trinamic/TOSV-AddonHardwareReferenceDesign/README.md

# TOSV-AddonHardwareReferenceDesign
Reference Design for the TOSV Pressure Sensor Addon Board
