trinamic/TOSV-AddonHardwareReferenceDesign/TOSV-SENSOR-REF V1.0/Production files/Transcode Report.txt

   ---- Transcoding 'Y:\Syslab\Projekte\TMCM-0021 (TOSV Addon Board)\hardware\TMCM-0021 v1.0\Production files\TMCM-0021 v1.0-B_Cu.gbr' ----   Tue Jun 02 15:44:44 2020

D10   --> D100
D11   --> D101
-----------------------------------------------------------------
