trinamic/TOSV-AddonHardwareReferenceDesign/TOSV-SENSOR-REF V1.0/Documentation/TMCM-0021 v1.0 - 3D rendering top.png

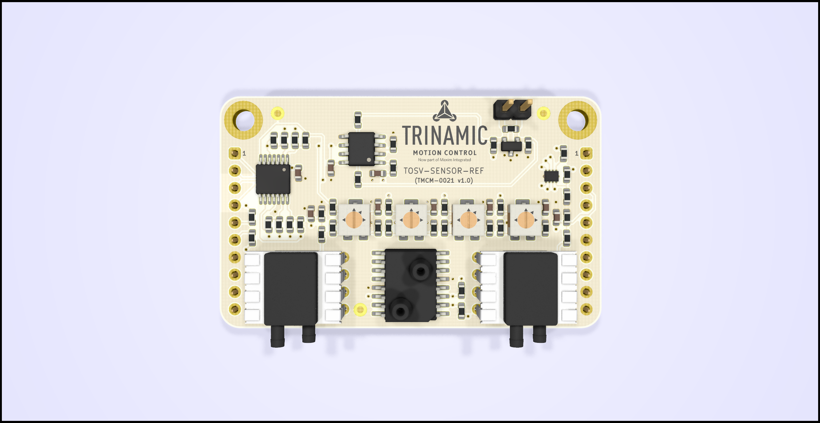
TOSV-SENSOR-REF V1.0/Documentation/TMCM-0021 v1.0 - 3D rendering top.png
