trinamic/TOSV-AddonHardwareReferenceDesign/TOSV-SENSOR-REF V1.0/Documentation/TMCM-0021 v1.0 - BOM.xlsx

Sheet: Revision hisroty
Release | Date | Comment
TMCM-0021 v1.0 | 2020-05-26 | First release

Sheet: BOM
Parts list
TMCM-0021 v1.0
2020-05-26
# | REFDES | QTY | VALUE | PACKAGE | INFO | ASSY | MANUFACTURER | MANUFACTURER PN | SUPPLIER | SUPPLIER PN | COMMON
1 | C101, C102, C103, C104, C105, C201, C202, C203, C204, | 9 | 100nF/10V/0603 | Capacitor_SMD:C_0603_1608Metric |  | SMD | KEMET | C0603C104K8RACTU | Digikey | 399-1095-1-ND | ✔
2 | D101, | 1 | SZNUP2105L | Package_TO_SOT_SMD:SOT-23 |  | SMD | ON Semiconductor | SZNUP2105LT1G | Digikey | SZNUP2105LT1GOSCT-ND
3 | IC101, | 1 | ADS7142IRUGR | KiCad library:ADS7142IRUGR |  | SMD | Texas Instruments | ADS7142IRUGR | Digikey | 296-50464-1-ND
4 | IC102, | 1 | SN65HVD1781D | SN65HVD1781DR:SN65HVD1781DR |  | SMD | Texas Instruments | SN65HVD1781DR | Digikey | 296-23118-1-ND
5 | J101, J102, | 2 | Conn_01x10 | Connector_PinSocket_2.54mm:PinSocket_1x10_P2.54mm_Vertical |  | THT | TE Connectivity AMP Connectors | TE Connectivity AMP Connectors | Digikey | A32910-ND | ✔
6 | J103, | 1 | Conn_01x02 | Connector_PinHeader_2.54mm:PinHeader_1x02_P2.54mm_Vertical |  | THT | TE Connectivity AMP Connectors | 87220-2 | Digikey | A26542-ND | ✔
7 | R101, | 1 | 0Ω/1%/0603 | Resistor_SMD:R_0603_1608Metric |  | SMD | Yageo | RC0603JR-070RL | Digikey | 311-0.0GRCT-ND | ✔
8 | R102, | 1 | 0Ω/1%/0603 | Resistor_SMD:R_0603_1608Metric | Not mounted | SMD | Yageo | RC0603JR-070RL | Digikey | 311-0.0GRCT-ND | ✔
9 | R103, R104, R105, R106, R209, R214, R217, R220, | 8 | 1kΩ/1%/0603 | Resistor_SMD:R_0603_1608Metric |  | SMD | Yageo | RC0603FR-071KL | Digikey | 311-1.00KHRCT-ND | ✔
10 | R107, R113, R118, R202, R203, R204, R205, | 7 | 10kΩ/1%/0603 | Resistor_SMD:R_0603_1608Metric |  | SMD | Yageo | RC0603FR-0710KL | Digikey | 311-10.0KHRCT-ND | ✔
11 | R110, R117, | 2 | 390Ω/1%/0603 | Resistor_SMD:R_0603_1608Metric | Not mounted | SMD | TE Connectivity Passive Product | CRGCQ0603F390R | Digikey | A129683CT-ND | ✔
12 | R111, R116, | 2 | 10Ω/1%/0603 | Resistor_SMD:R_0603_1608Metric | CRCW0603010RJNEAHP | SMD | Yageo | RC0603FR-0710RL | Digikey | 311-10.0HRCT-ND | ✔
13 | R112, R119, | 2 | 3,9kΩ/1%/0603 | Resistor_SMD:R_0603_1608Metric |  | SMD | Panasonic Electronic Components | ERA-3AEB392V | Digikey | P3.9KDBCT-ND | ✔
14 | R114, R120, | 2 | 7,5kΩ/1%/0603 | Resistor_SMD:R_0603_1608Metric |  | SMD | Susumu | RR0816P-752-D | Digikey | RR08P7.5KDCT-ND | ✔
15 | R115, | 1 | 220Ω/1%/0603 | Resistor_SMD:R_0603_1608Metric | Not mounted | SMD | Yageo | RC0603FR-07220RL | Digikey | 311-220HRCT-ND | ✔
16 | R201, R212, R215, R218, | 4 | 4,7kΩ/1%/0603 | Resistor_SMD:R_0603_1608Metric |  | SMD | Susumu | RR0816P-472-D | Digikey | RR08P4.7KDCT-ND | ✔
17 | R206, R213, R216, R219, | 4 | 47kΩ/1%/0603 | Resistor_SMD:R_0603_1608Metric |  | SMD | Yageo | RC0603FR-0747KL | Digikey | 311-47.0KHRCT-ND | ✔
18 | R207, R208, R210, R211, | 4 | 4,7MΩ/1%/0603 | Resistor_SMD:R_0603_1608Metric |  | SMD | Yageo | RC0603FR-074M7L | Digikey | 311-4.70MHRCT-ND | ✔
19 | RV201, RV202, RV203, RV204, | 4 | 22kΩ/20% | Potentiometer_SMD:Potentiometer_Bourns_3314J_Vertical | 3314J-1-223E | SMD | Bourns Inc. | 3314J-1-223E | Digikey | 3314J-1-223ECT-ND | ✔
20 | U101, U103, | 2 | SSCDRRN160MGAA5 | Package_DIP:DIP-8_W13.08mm |  | THT | Honeywell Sensing and Productivity Solutions | SSCDRRN160MGAA5 | Digikey | SSCDRRN160MGAA5-ND
21 | U102, | 1 | SM9333-BCE-S-125-000 | Package_SO:SOIC-16W_7.5x10.3mm_P1.27mm |  | SMD | Silicon Microstructures, Inc. | SM9333-BCE-S-125-000 | Mouser | 987-SM9333BCES125000
22 | U201, | 1 | MAX9095AUD+T | Package_SO:TSSOP-14_4.4x5mm_P0.65mm |  | SMD | Maxim Integrated | MAX9095AUD+T | Digikey | MAX9095AUD+TCT-ND
