trinamic/TOSV-AddonHardwareReferenceDesign/TOSV-SENSOR-REF V1.0/Documentation/TMCM-0021 v1.0.step

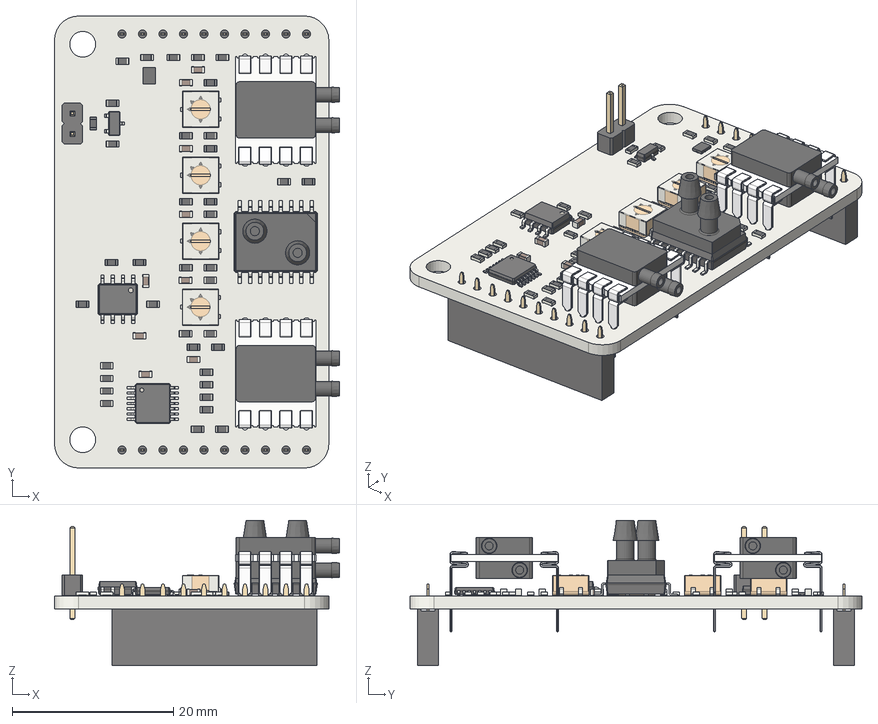
[picture p4: CAD file, 2020-06-11]
TOSV-SENSOR-REF V1.0/Documentation/TMCM-0021 v1.0.step
35.3 x 56.0 x 18.0 mm
