trinamic/TOSV-AddonHardwareReferenceDesign/TOSV-SENSOR-REF V1.0/Documentation/TMCM-0021 v1.0 - Schematic.pdf

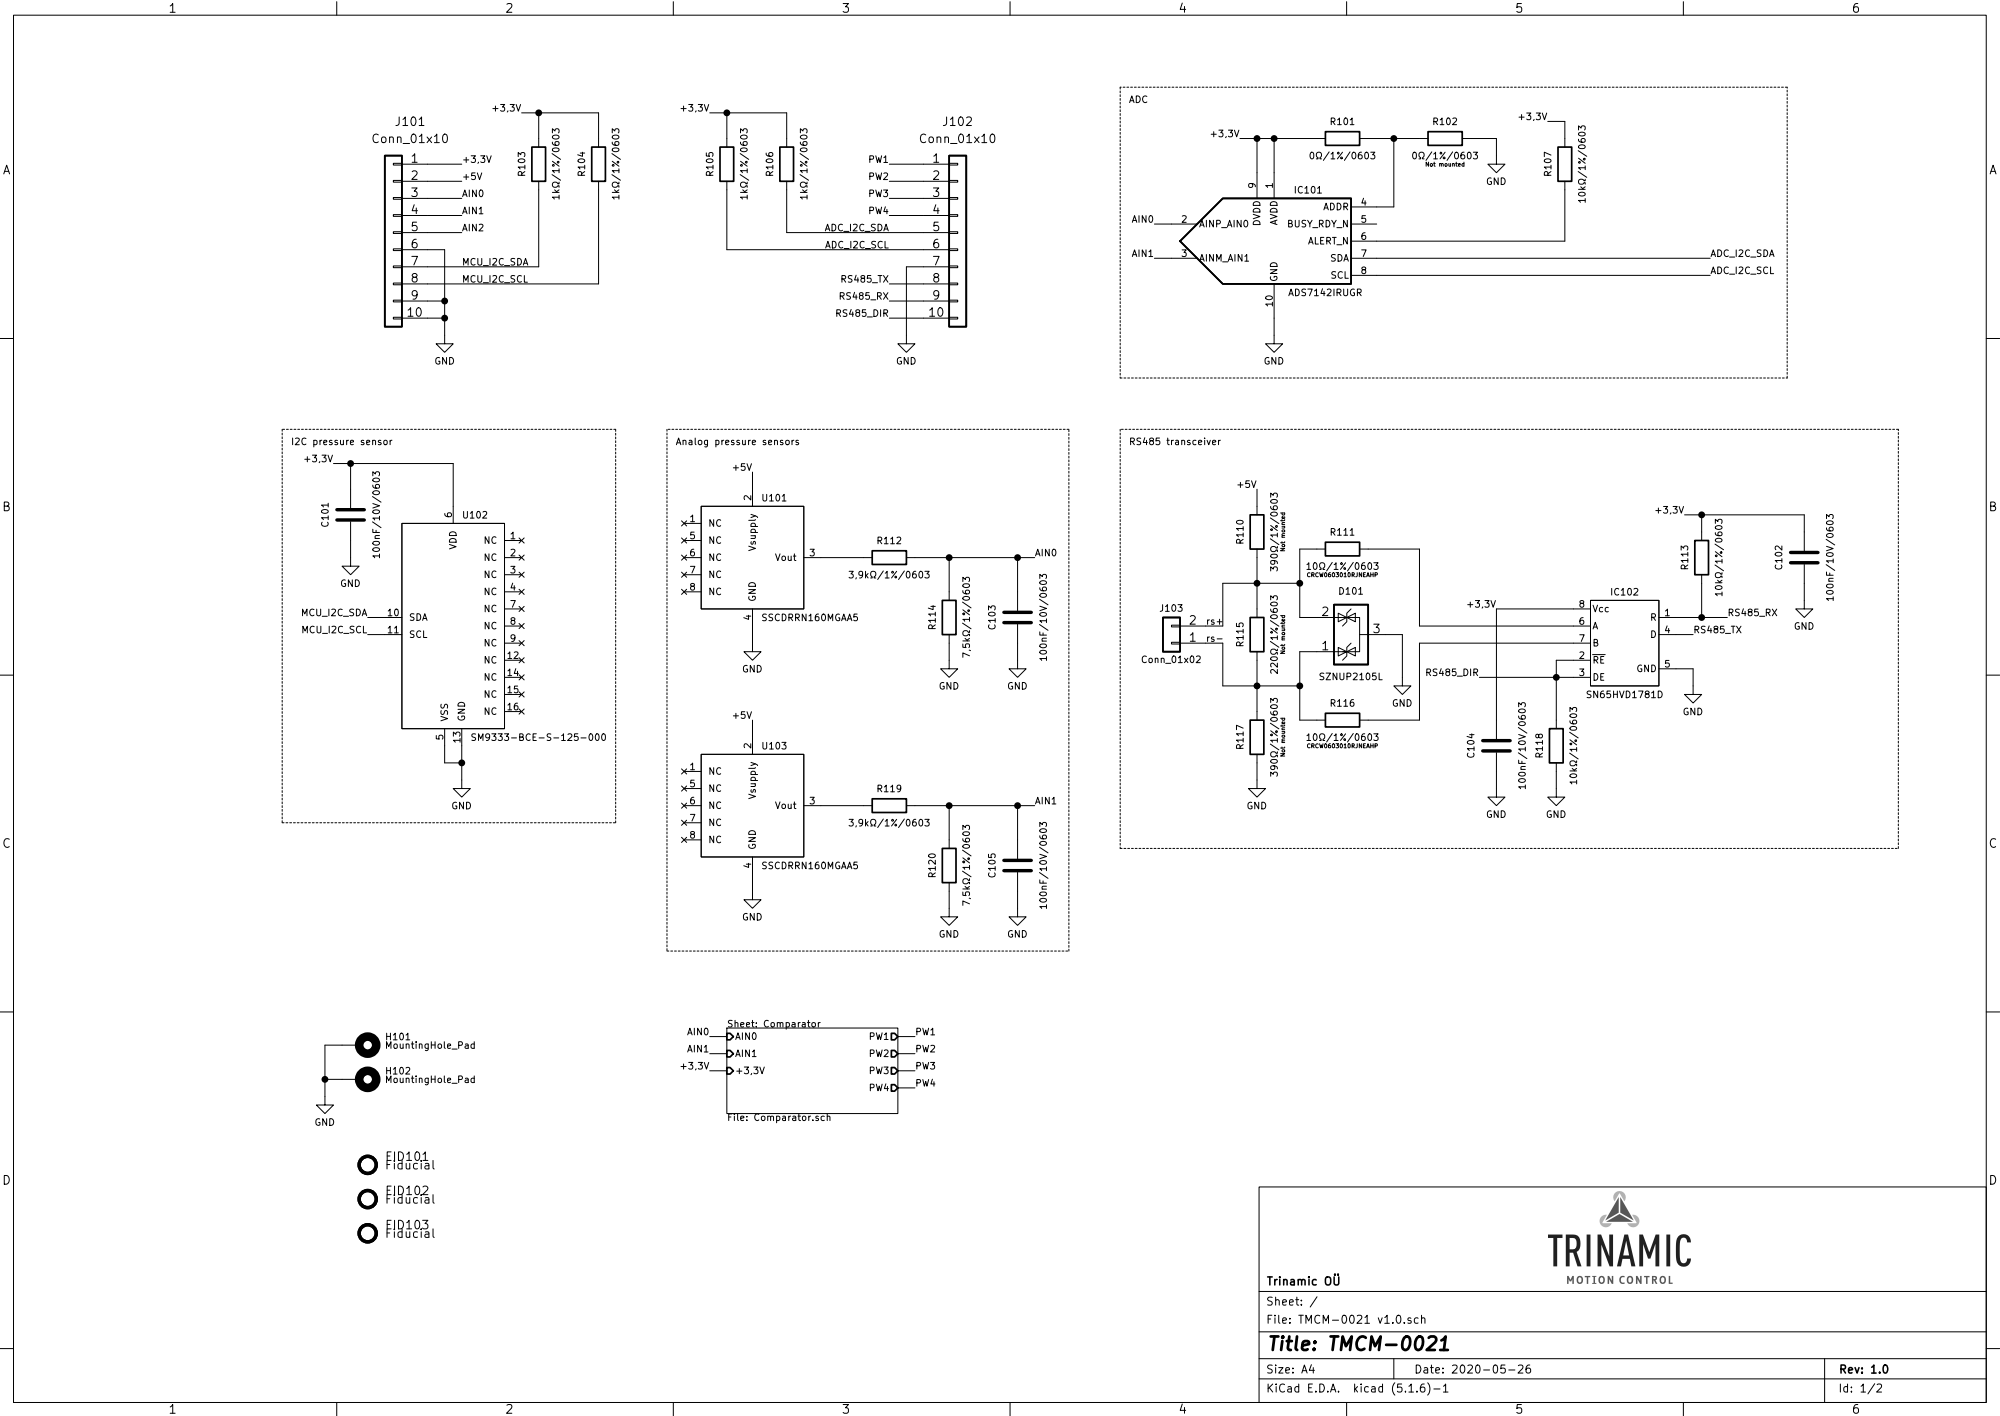
[picture p5: page 1]

1 GND 10 AINP_AIN0 2 AINM_AIN1 3 ADDR 4 BUSY_RDY_N 5 ALERT_N 6 SDA 7 SCL 8 DVDD

4 NC 5 NC 6 NC 7 NC 8 U101 SSCDRRN160MGAA5 R112

4 NC 5 NC 6 NC 7 NC 8 U103 SSCDRRN160MGAA5 R

File: TMCM-0021 v1.0.sch Sheet: / Trinamic OÜ

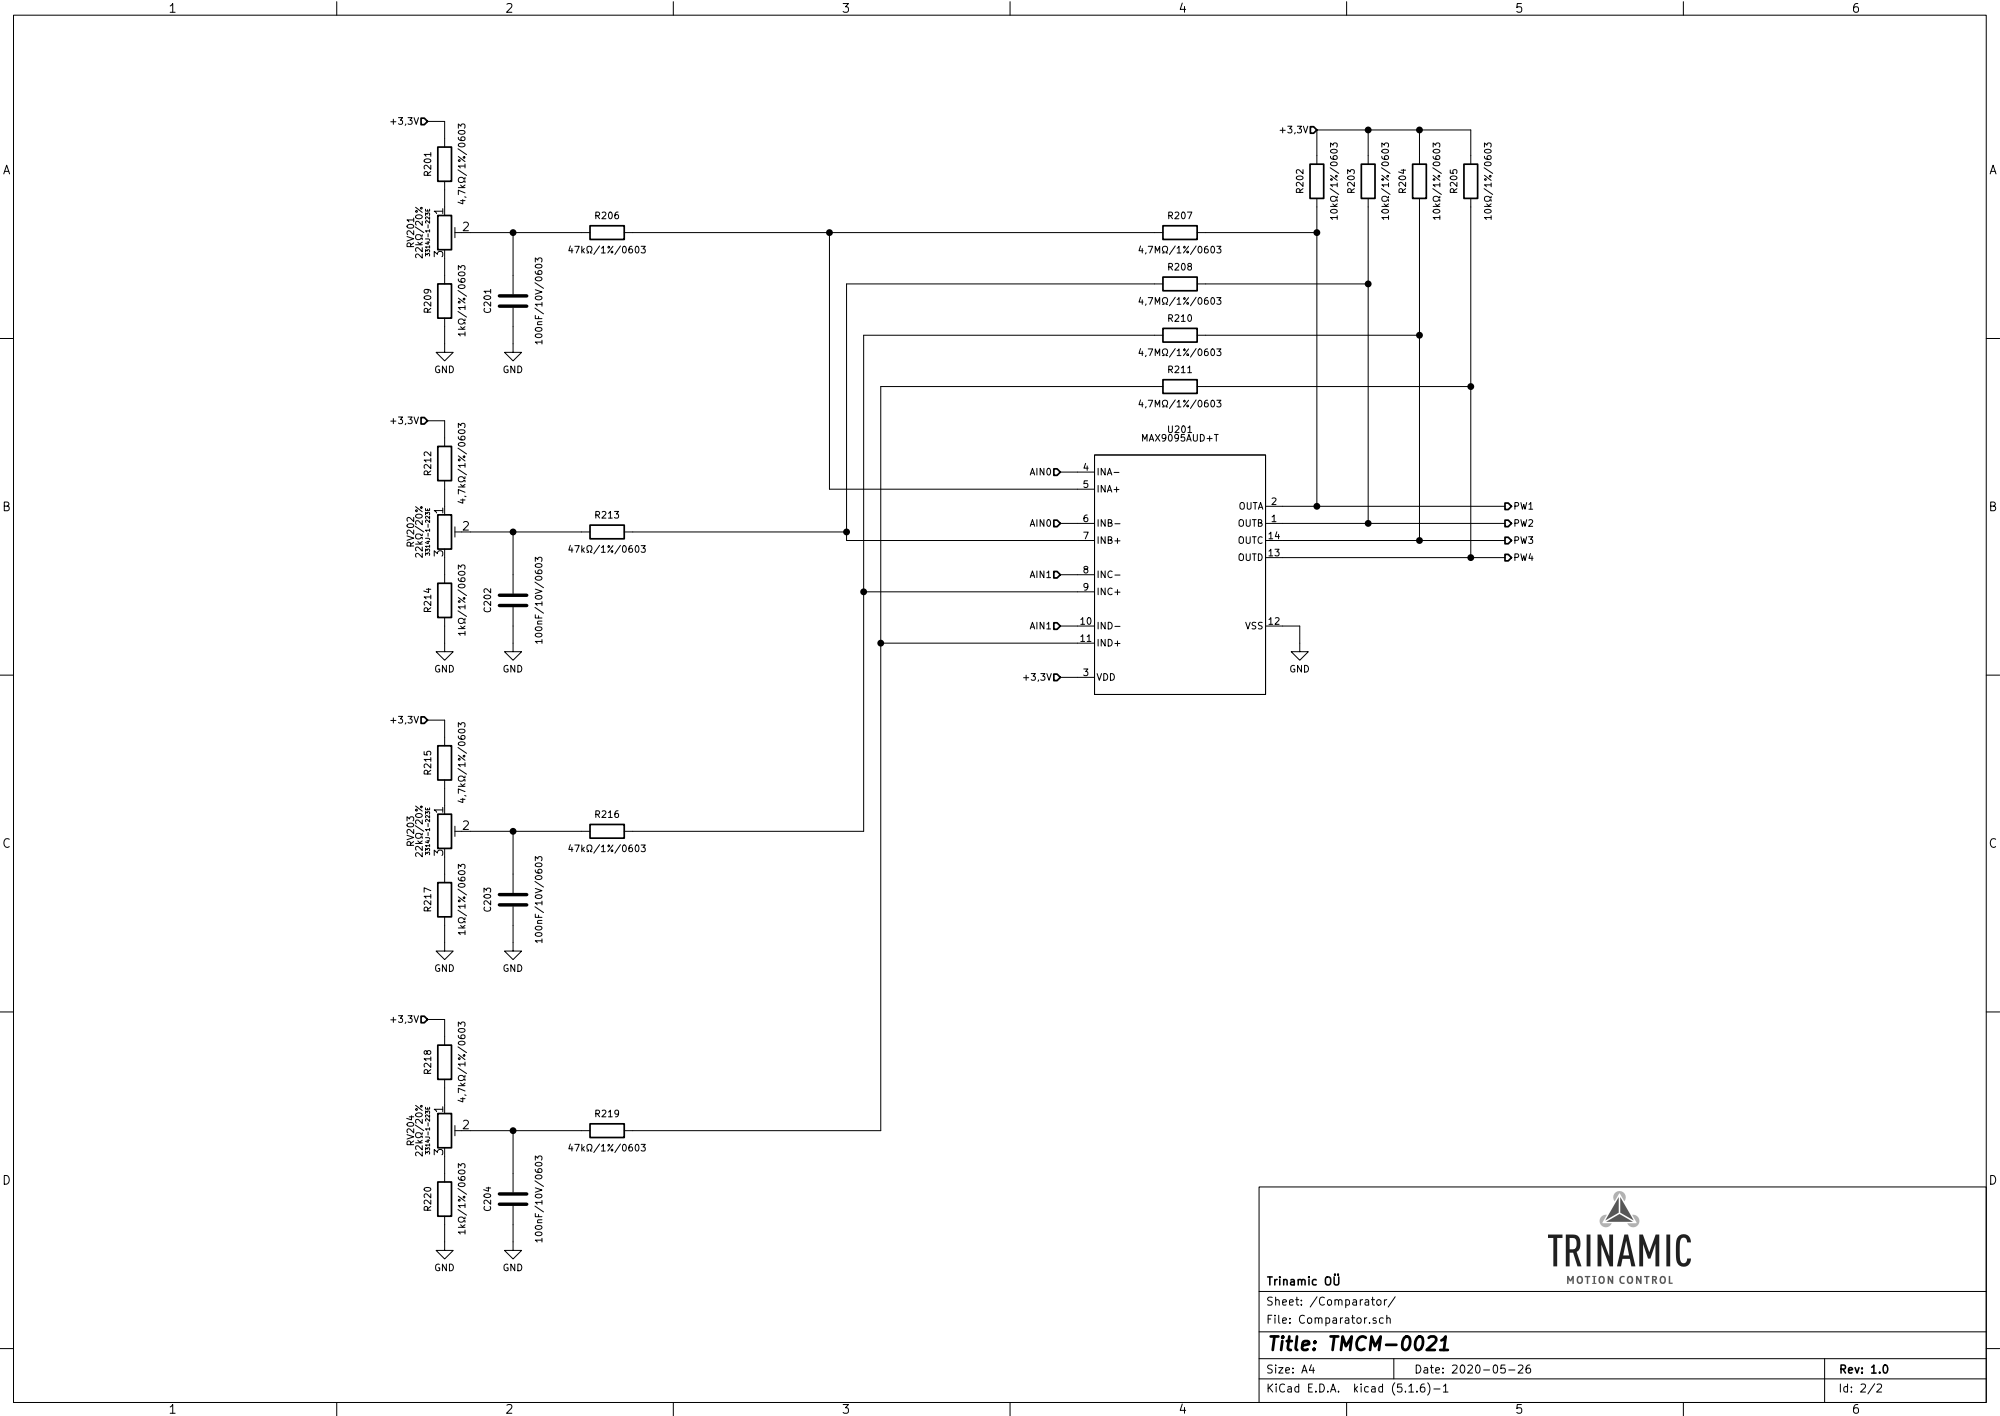
[picture p6: page 2]

File: Comparator.sch Sheet: /Comparator/ Trinamic OÜ
