trinamic/TOSV-AddonHardwareReferenceDesign/TOSV-SENSOR-REF V1.0/CAD/TMCM-0021 v1.0.kicad_pcb

## KiCad design TOSV-SENSOR-REF V1.0/CAD/TMCM-0021 v1.0.kicad_pcb (2020-06-19)

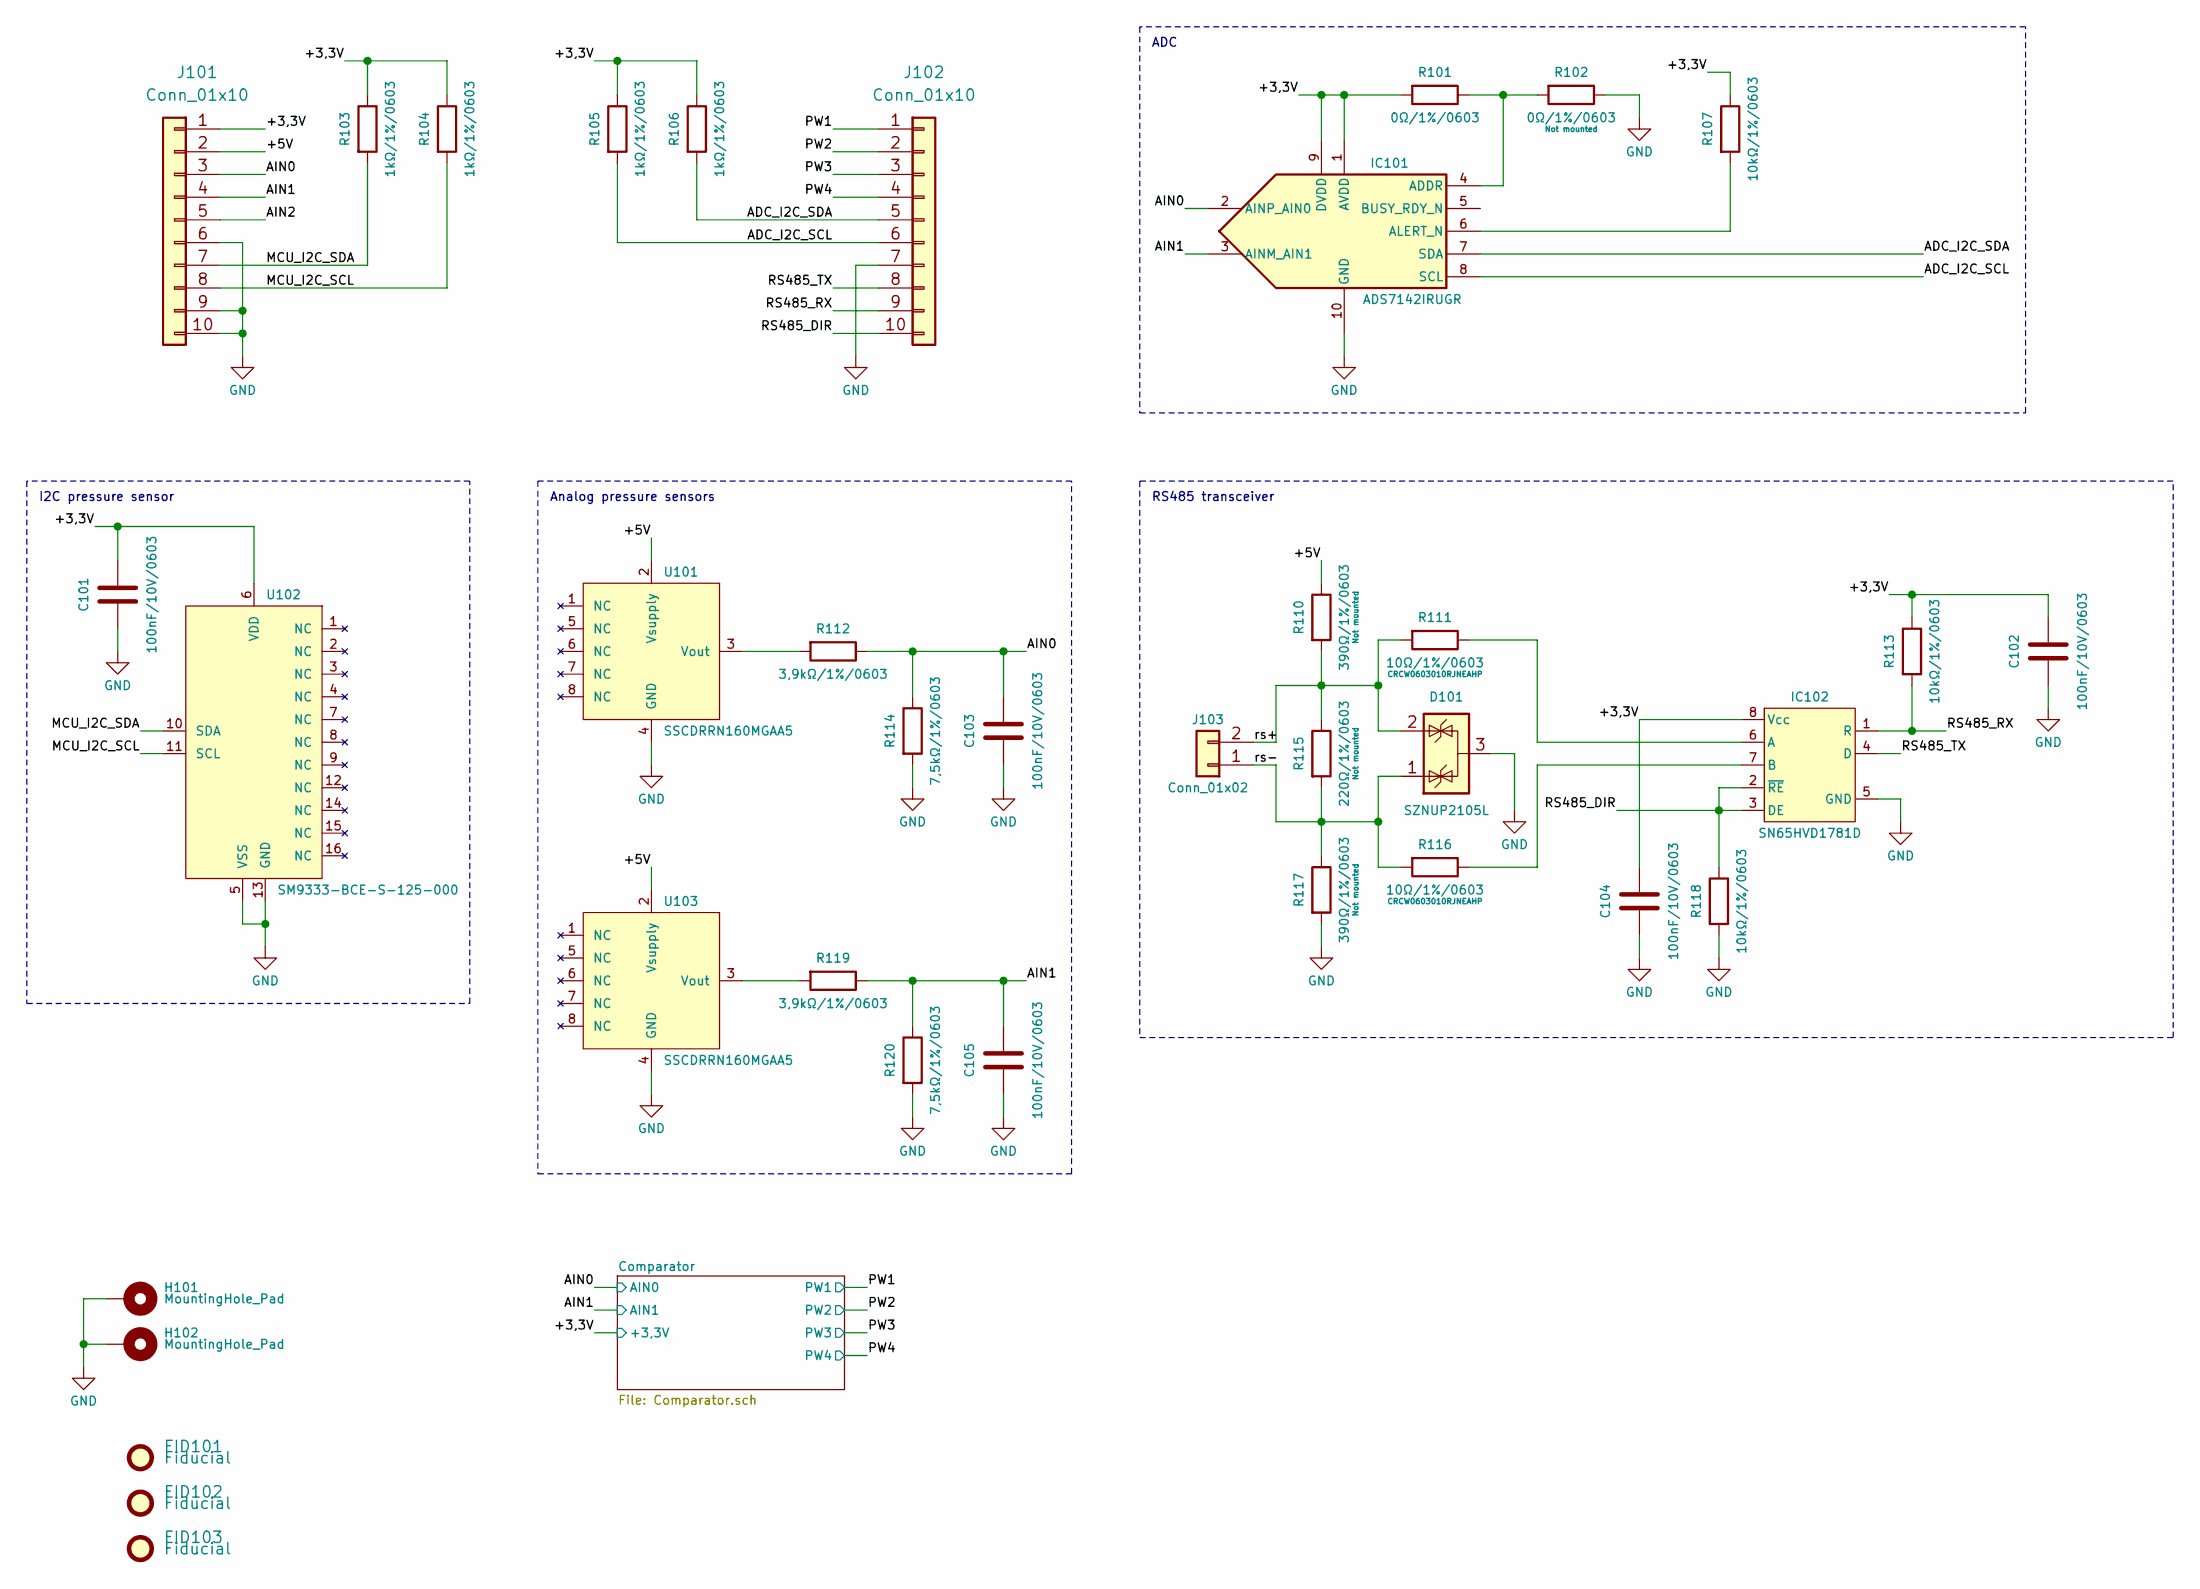
[picture p13: schematic TMCM-0021 v1.0.sch, TMCM-0021]

Parts:
C101, C102, C103, C104, C105: 100nF/10V/0603; C_0603_1608Metric
D101: SZNUP2105L; SOT-23
FID101, FID102, FID103: Fiducial; Fiducial_1mm_Mask2mm
H101, H102: MountingHole_Pad; MountingHole_3.2mm_M3_Pad
IC101: ADS7142IRUGR
IC102: SN65HVD1781D; SN65HVD1781DR
J101, J102: Conn_01x10; PinSocket_1x10_P2.54mm_Vertical
J103: Conn_01x02; PinHeader_1x02_P2.54mm_Vertical
R101, R102: 0Ω/1%/0603; R_0603_1608Metric
R103, R104, R105, R106: 1kΩ/1%/0603; R_0603_1608Metric
R107, R113, R118: 10kΩ/1%/0603; R_0603_1608Metric
R110, R117: 390Ω/1%/0603; R_0603_1608Metric
R111, R116: 10Ω/1%/0603; R_0603_1608Metric
R112, R119: 3,9kΩ/1%/0603; R_0603_1608Metric
R114, R120: 7,5kΩ/1%/0603; R_0603_1608Metric
R115: 220Ω/1%/0603; R_0603_1608Metric
U101, U103: SSCDRRN160MGAA5; DIP-8_W13.08mm
U102: SM9333-BCE-S-125-000; SOIC-16W_7.5x10.3mm_P1.27mm

Connections:
/+3,3V: C101.1, C102.1, C104.1, IC101.1 (AVDD), IC101.9 (DVDD), IC102.8 (Vcc), J101.1, R101.2, R103.1, R104.1, R105.1, R106.1, R107.1, R113.1, U102.6 (VDD); also elsewhere on the board
/+5V: J101.2, R110.1, U101.2 (Vsupply), U103.2 (Vsupply)
/ADC_I2C_SCL: IC101.8 (SCL), J102.6, R105.2
/ADC_I2C_SDA: IC101.7 (SDA), J102.5, R106.2
/AIN0: C103.1, IC101.2 (AINP_AIN0), J101.3, R112.1, R114.1; also elsewhere on the board
/AIN1: C105.1, IC101.3 (AINM_AIN1), J101.4, R119.1, R120.1; also elsewhere on the board
/MCU_I2C_SCL: J101.8, R104.2, U102.11 (SCL)
/MCU_I2C_SDA: J101.7, R103.2, U102.10 (SDA)
/PW1: J102.1; also elsewhere on the board
/PW2: J102.2; also elsewhere on the board
/PW3: J102.3; also elsewhere on the board
/PW4: J102.4; also elsewhere on the board
/RS485_DIR: IC102.2 (~RE), IC102.3 (DE), J102.10, R118.1
/RS485_RX: IC102.1 (R), J102.9, R113.2
/RS485_TX: IC102.4 (D), J102.8
/rs+: D101.2 (K), J103.2, R110.2, R111.2, R115.1
/rs-: D101.1 (K), J103.1, R115.2, R116.2, R117.1
GND: C101.2, C102.2, C103.2, C104.2, C105.2, D101.3 (A), H101.1, H102.1, IC101.10 (GND), IC102.5 (GND), J101.6, J101.9, J101.10, J102.7, R102.1, R114.2, R117.2, R118.2, R120.2, U101.4 (GND), U102.5 (VSS), U102.13 (GND), U103.4 (GND); also elsewhere on the board
unnamed: IC101.4 (ADDR), R101.1, R102.2
unnamed: IC101.6 (ALERT_N), R107.2
unnamed: IC102.6 (A), R111.1
unnamed: IC102.7 (B), R116.1
unnamed: R112.2, U101.3 (Vout)
unnamed: R119.2, U103.3 (Vout)

Notes on the sheet:
Analog pressure sensors
I2C pressure sensor
ADC
RS485 transceiver

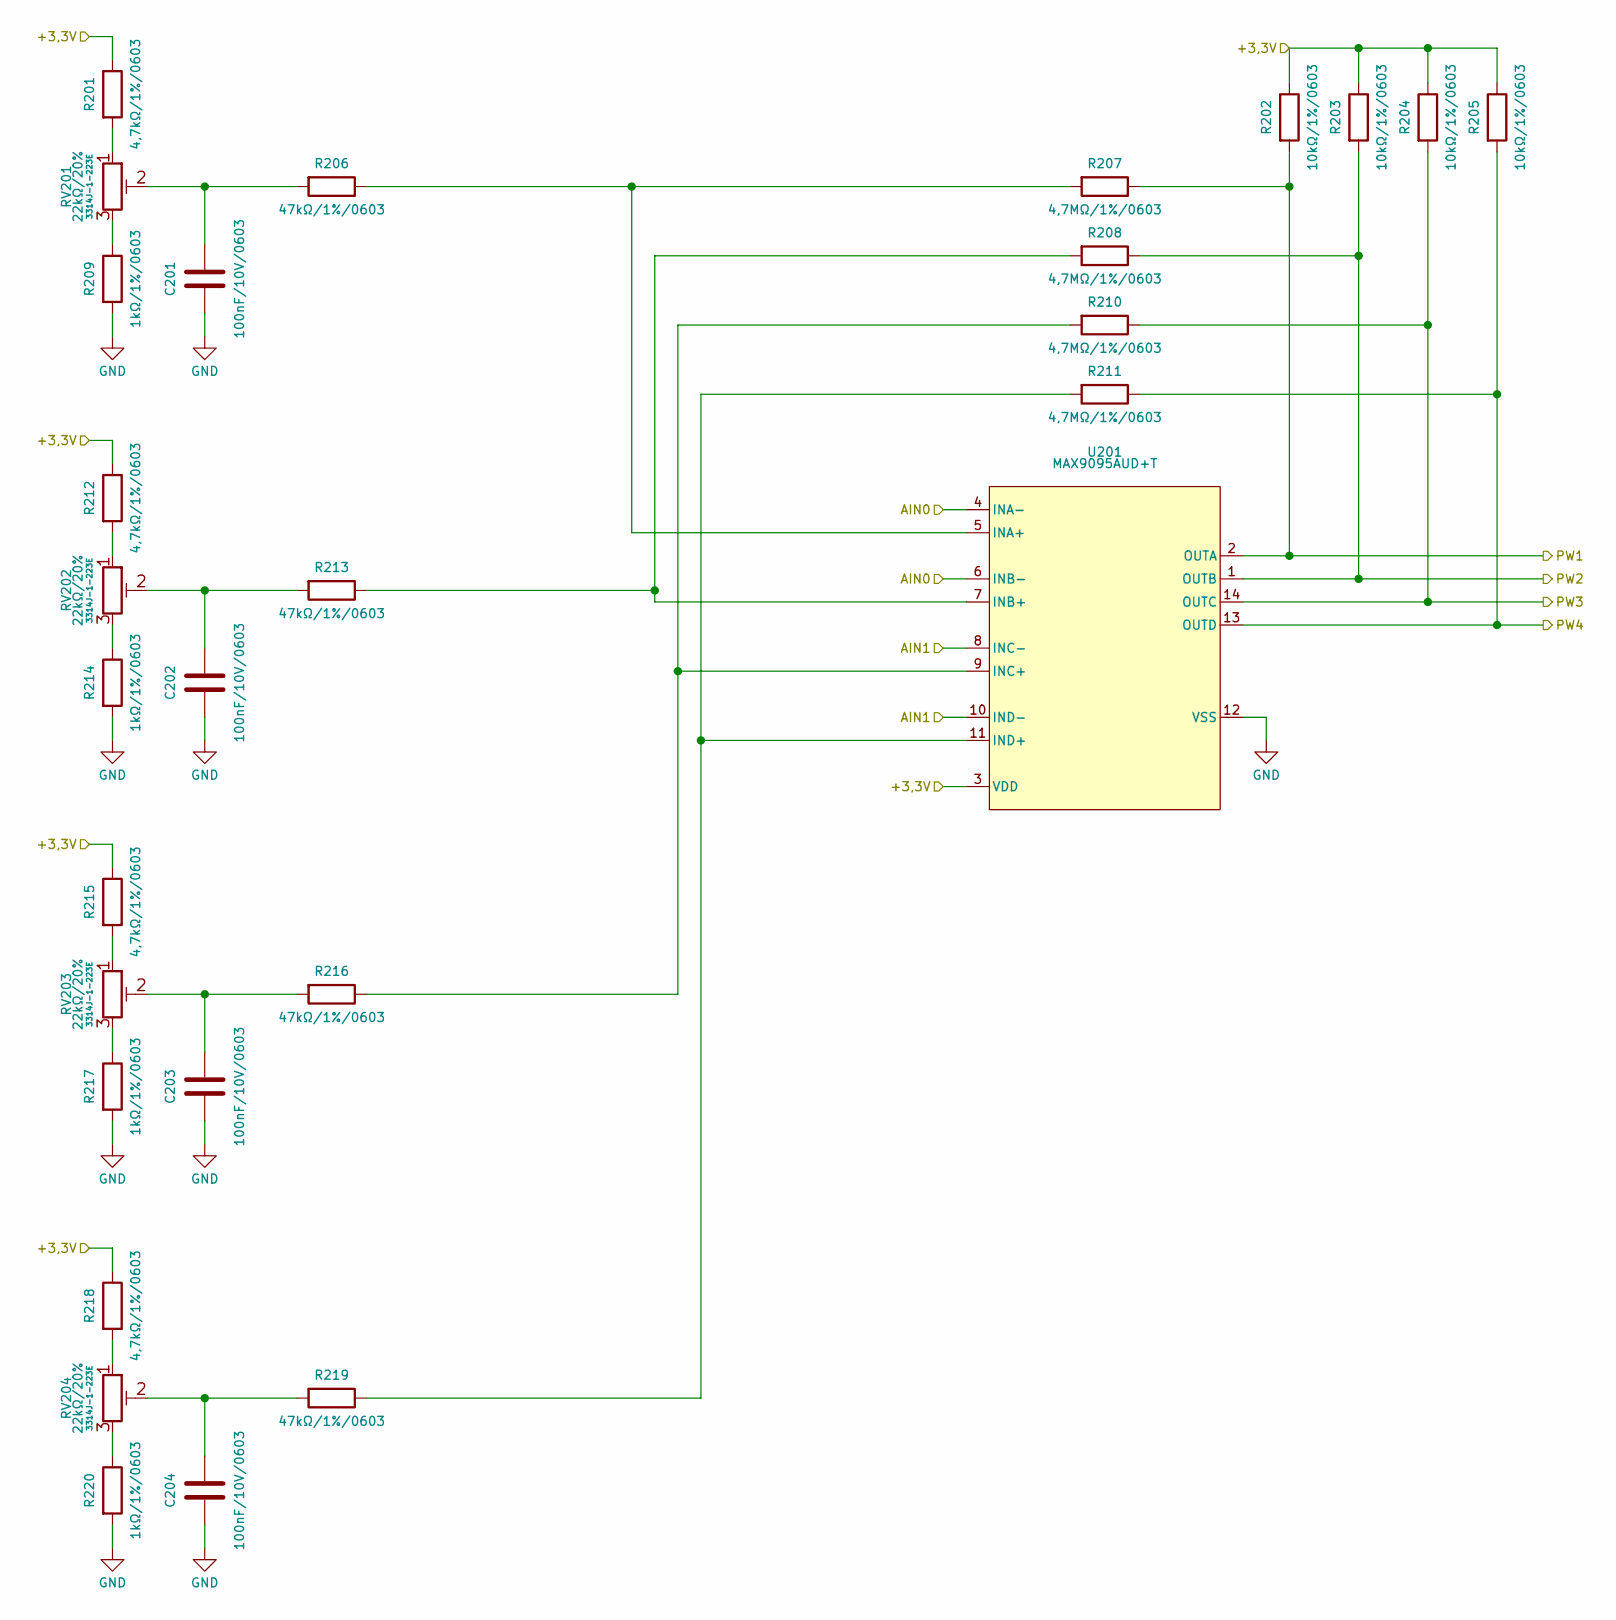
[picture p14: schematic Comparator.sch, TMCM-0021]

Parts:
C201, C202, C203, C204: 100nF/10V/0603; C_0603_1608Metric
R201, R212, R215, R218: 4,7kΩ/1%/0603; R_0603_1608Metric
R202, R203, R204, R205: 10kΩ/1%/0603; R_0603_1608Metric
R206, R213, R216, R219: 47kΩ/1%/0603; R_0603_1608Metric
R207, R208, R210, R211: 4,7MΩ/1%/0603; R_0603_1608Metric
R209, R214, R217, R220: 1kΩ/1%/0603; R_0603_1608Metric
RV201, RV202, RV203, RV204: 22kΩ/20%; Potentiometer_Bourns_3314J_Vertical
U201: MAX9095AUD+T; TSSOP-14_4.4x5mm_P0.65mm

Connections:
/+3,3V: R201.1, R202.1, R203.1, R204.1, R205.1, R212.1, R215.1, R218.1, U201.3 (VDD); also elsewhere on the board
/AIN0: U201.4 (INA-), U201.6 (INB-); also elsewhere on the board
/AIN1: U201.8 (INC-), U201.10 (IND-); also elsewhere on the board
/PW1: R202.2, R207.1, U201.2 (OUTA); also elsewhere on the board
/PW2: R203.2, R208.1, U201.1 (OUTB); also elsewhere on the board
/PW3: R204.2, R210.1, U201.14 (OUTC); also elsewhere on the board
/PW4: R205.2, R211.1, U201.13 (OUTD); also elsewhere on the board
GND: C201.2, C202.2, C203.2, C204.2, R209.2, R214.2, R217.2, R220.2, U201.12 (VSS); also elsewhere on the board
unnamed: C201.1, R206.2, RV201.2
unnamed: C202.1, R213.2, RV202.2
unnamed: C203.1, R216.2, RV203.2
unnamed: C204.1, R219.2, RV204.2
unnamed: R201.2, RV201.1
unnamed: R206.1, R207.2, U201.5 (INA+)
unnamed: R208.2, R213.1, U201.7 (INB+)
unnamed: R209.1, RV201.3
unnamed: R210.2, R216.1, U201.9 (INC+)
unnamed: R211.2, R219.1, U201.11 (IND+)
unnamed: R212.2, RV202.1
unnamed: R214.1, RV202.3
unnamed: R215.2, RV203.1
unnamed: R217.1, RV203.3
unnamed: R218.2, RV204.1
unnamed: R220.1, RV204.3

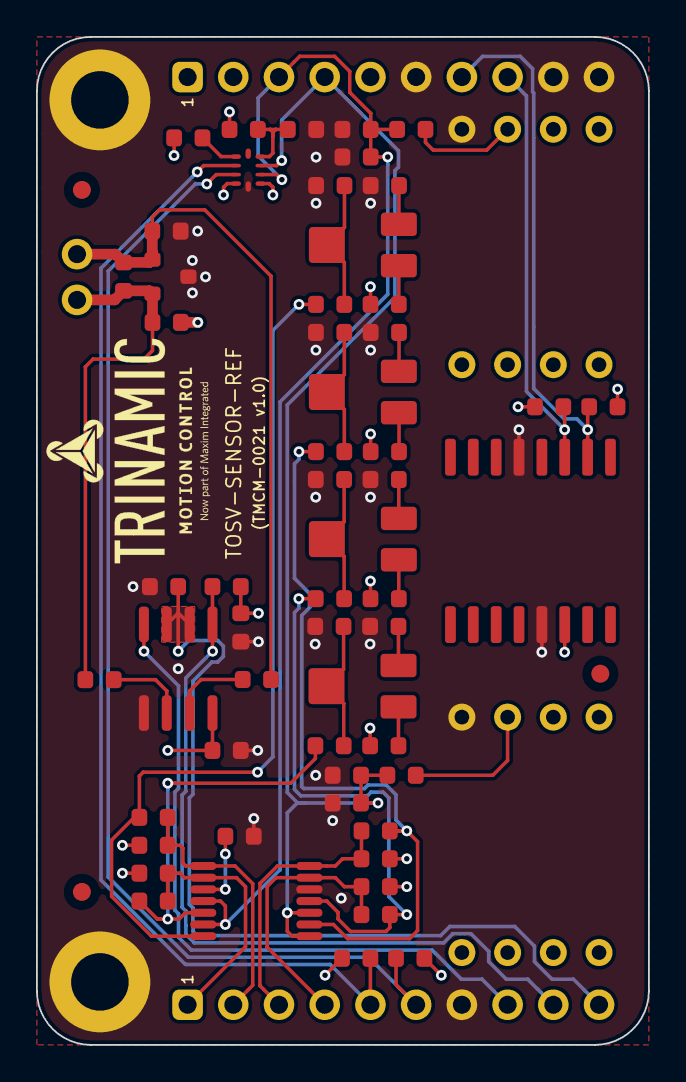
[picture p15: board TMCM-0021 v1.0.kicad_pcb from above]

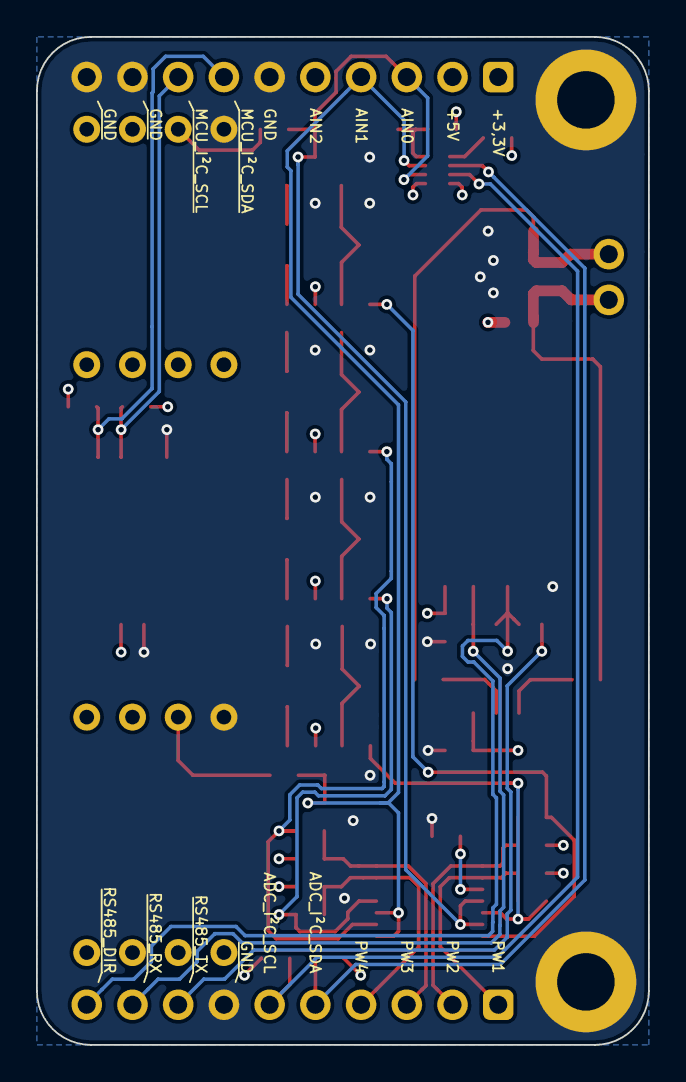
[picture p16: board TMCM-0021 v1.0.kicad_pcb from below]

Board: 4 copper layers, 34.0 x 56.0 mm, 66 parts (2 on the bottom side), 40 nets.
