trinamic/TOSV-AddonHardwareReferenceDesign/(commit log)

2020-06-11 First V1.0 Commit of the TOSV Pressure Sensor Reference Design
    [Comparator.sch, TMCM-0021 v1.0 - BOM.tsv, TMCM-0021 v1.0 - BOM.xlsx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]
2020-06-11 3D file added and rendering update
    3D file in .step format and windows 3D viewer format.
    [TMCM-0021 v1.0.step]
2020-06-19 Silkscree Update
    [TMCM-0021 v1.0.kicad_pcb]
2020-06-19 Silkscreen Top Update
    [TMCM-0021 v1.0-F_SilkS.gbr]
